noahg460505/Noahs-Independent-Study/README.md

# Noah's Independent Study
Repository for my semester long engineering self-study project.  

[Project Proposal](./Project-Proposal.md) 

[6-6-6 Plan](./6-6-6-Plan.md) 

[Daily Documentation](./Daily-Documentation.md) 

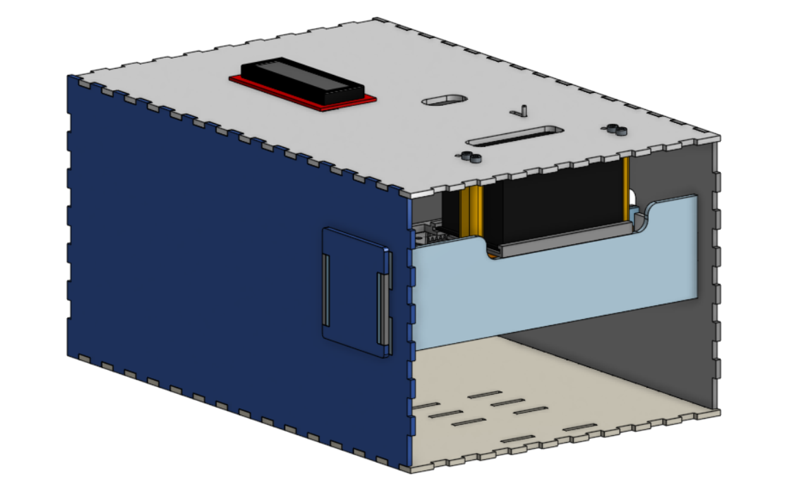
[picture p1: Media/Final CAD Screenshots/final-cad-screenshots-8.png]
Final CAD Screenshot
