noahg460505/Noahs-Independent-Study/Reflection.md

# Self-Study Project Reflection
## What did I do on the project?
    - Python code
    - Arduino code
    - Serial interface and commands
    - Prototyping
    - CAD Design
    - Glued my fingers together numerous times with CA glue

## What challenges did I overcome?
The biggest challenge that I had to overcome was the cutter for the thermal printer. It took so, so many small tweaks, and it wasn't even something I originally thought I would need to design for this project! I fully forgot that you normally have to manually tear paper off of a thermal printer, it doesn't just detach when it's done printing. Another issue I had to overcome was getting the drawer to slide smoothly, I used graphic lubricant and made a huge mess to get it to slide smoothly, but it's smooth now!

## What would I do differently?
I would absolutely decrease the scope for the project with the knowledge that a thermal printer doesn't cut it's own paper (should've been obvious, but slipped my mind). I would also consider earlier how to do the rails for the drawer and properly eject it, since I really just kinda ran out of time to design and plan that and just did random stuff (i.e. servo, gear motor spinning wheel underneath to roll drawer, etc) before running out of time with an unreliable servo design that can't retract itself, nor consistently eject itself. I would also make the rails extend longer instead of just at the front of the box so that it doesn't tilt backwards when retracted.

## What did I learn in prior classes that I applied to this project
    - CAD — every class since engineering, but Onshape from Mechatronics (widget sorter project)
    - Arduino code — From mechatronics
    - Python code — Game design 2 + Mechatronics (widget sorter project)
    - Complex Arduino wiring — Mechatronics
    - 3D printing and prototyping — Mechatronics (widget sorter project)
    - Large laser cut boxes/finger joint boxes — Mechatronics
