noahg460505/Noahs-Independent-Study/Daily-Documentation.md

# Daily Documentation
## Week 1
### Day 1 - 2026-01-29
Today I discussed my initial ideas with Mr. Small and how this independent study will actually work. I created this GitHub repository and began doing some planning, I created my initial [6-6-6 plan](./6-6-6-Plan.md).

## Week 2
### Day 2 - 2026-02-02
Today I worked on my GitHub repository more. I added an initial BOM to my [project proposal](./Project-Proposal.md) and created [Daily-Documentation.md](Daily-Documentation.md)

### Day 3 - 2026-02-04
Today I really didn't feel like working on the GitHub repo so I started on some [Python code](./Code/main.py).

### Day 4 - 2026-02-06
I think my proposal is all ready, just need to find a specific thermal printer to buy. Today I mostly just worked on my Health 2 online stuff during class.

## Week 3
### Day 5 - 2026-02-10
Today I once again just worked on Health 2 online stuff while waiting for Mr. Small, he told me he was gonna look at the project proposal this weekend but he was busy, hopefully next class?

### Day 6 - 2026-02-12
Today I worked more on the Python code because I was tired
why do i only ever feel like doing code when im tired

Next class I think I'll start prototyping, assuming Mr. Small looks at my project proposal over the weekend.

## Week 4
### Day 7 - 2026-02-17
Today I talked to Mr. Small and discussed my project and ordering a thermal printer for the project. I also worked on the Python code a bit more.

### Day 8 - 2026-02-19
Worked on Arduino code for most of the time, once I got the Arduino IDE working on my laptop.
I'm tired, my birthday was yesterday, I stayed up kinda late

## Week 5
### Day 9 - 2026-02-23
Today I did wiring for the character LCD and got the display fully working! I finished the [display Arduino code](./Code/arduinoSelfStudyCode.ino) and worked on the [Python code](./Code/main.py) a bit more.  
No Messages Waiting   
Countdown   
[Countdown Test Video](/Media/2026-02-23-Countdown-Test.mp4)   

### Day 10 - 2026-02-25
Today I tried to get some motor stuff running for testing, but I instead just shorted everything, including my laptop's USB-A port, thought I fully fried my laptop, it wouldn't turn back on, not even the keyboard backlight or display would light up. Fixed it by holding the power button for a minute, then waiting 30 minutes. Luckily, my laptop survived, it powered on after half-an-hour. Didn't get much done other than fail to get motors running and shorting stuff and nearly killing my rather expensive laptop.

### Day 11 - 2026-02-27
Today I just spent all of class diagnosing wiring issues, I was really struggling getting stuff to work. It appears that last class I fried the Arduino, it wouldn't do anything. I was trying to get motors to spin all class before I realized "Oh, I probably fried the H-Bridge too" so next class I'll replace the H-Bridge and run some tests.  
Dead Arduino  

## Week 6
### Day 12 - 2026-03-03
Yup, that H-Bridge was dead, after replacing it everything works!  
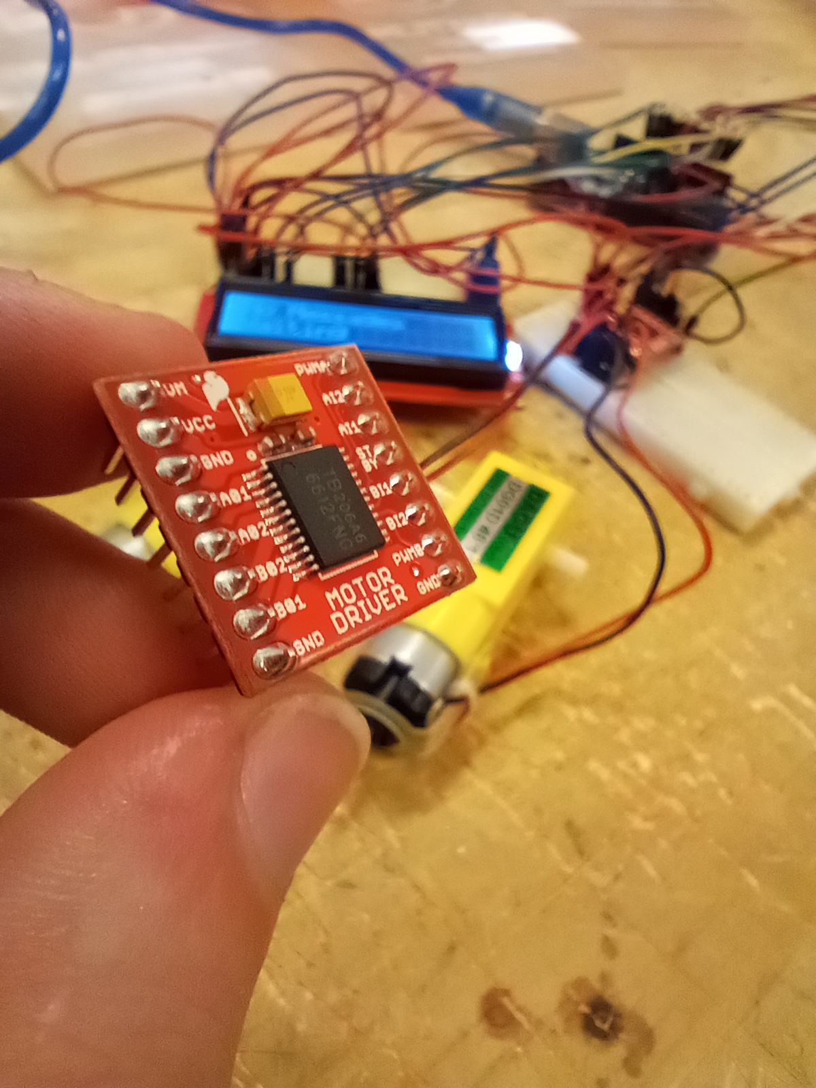
[picture p2: Media/2026-03-03-dead-h-bridge.jpg]
Dead H-Bridge
  
Supposed to have a deliverable this week, dunno how possible that's gonna be since I don't yet have the printer, although maybe the code + fully working wiring could count as a deliverable? I'll have to ask!  

Wiring on Table
   
Wiring Top View   
[Motor Test Video](/Media/2026-03-03-Motor-Test.mp4)   

### Day 13 - 2026-03-05
So today I realized two things, one is that I'll either need an Arduino Mega or a second Arduino Uno to add the thermal printer and possibly a servo if I add it. The other thing I realized is that most thermal printers don't have an autocutter, including mine, so I'll need to somehow mechanically cut the paper as it comes out of the thermal printer, it has a serrated edge that you are supposed to yank the paper against. I also permanently changed my USB permissions on my laptop for the Arduino serial so I don't need to do `sudo chmod a+rw /dev/ttyACM0` every time I plug in the Arduino.

    Current ideas:  
    - have some feeder wheels to yank it against the serrated edge  
    - have a razor blade that slides against the paper with a linear actuator with the paper under tension

## Week 7
### Day 14 - 2026-03-09
I mainly just worked on a personal project today during class because I'm still waiting on the thermal printer (Supposed to show up next week). Next class I might work on figuring out wiring up a second Arduino for running the printer.

### Day 15 - 2026-03-11
Honestly just worked on my Health 2 online stuff and also my personal project, really just waiting on the thermal printer for prototyping.
  
### Day 16 - 2026-03-13
Thermal printer has been delayed again, will be here on March 20th apparently. Since I really don't wanna do nothing for another week I think I'll try to begin on CAD.

## Week 8
### Day 17 - 2026-03-17
CAD

### Day 18 - 2026-03-19
more CAD

## Week 9
### Day 19 - 2026-03-30
Today I worked on a bit more CAD and also got an update on shipping for my thermal printer, it's arriving today! It keeps getting delayed but it should finally show up, then I can get it wired and finally begin making a housing for it.

### Day 20 - 2026-04-01
Today I FINALLY got my thermal printer, I did some test prints and got it working. I had to do a really jank solution to get it running as it needed 9v to work properly, but we only have 4 and 8 battery packs, so I had to get an 8 battery pack and then put wires to jump where two more batteries would be. I also tested how I would actually cut the paper, I found a box cutter blade segment works rather well, I think I'll have my friend Kevin design a motorized thing for moving the razor blade along the paper, as he is much better at moving, motorized systems than I am.
Thermal Printer  
Cutter Test  

### Day 21 - 2026-04-03
I was sick at home

## Week 10
### Day 22 - 2026-04-09
Tested the cutter system that Kevin helped me design, it works, somewhat, but there are some issue I need to deal with. Firstly, it is running at 9v, the motor has so much torque that the hard stop against the motor case doesn't stall the motor, it instead powers through the hard stop and breaks it off. Secondly, it has no idea if it has reached the end of the gear rack, but I might not need to fix this. I'll brainstorm how to fix this next class
Cutter Mechanism  
It broke :c  

## Week 11
### Day 23 - 2026-04-13
Today I just did some CAD, trying to figure out solutions to my problems. Namely, I designed a tip cover for the blade, hopefully this will help it cut easier and need less torque.
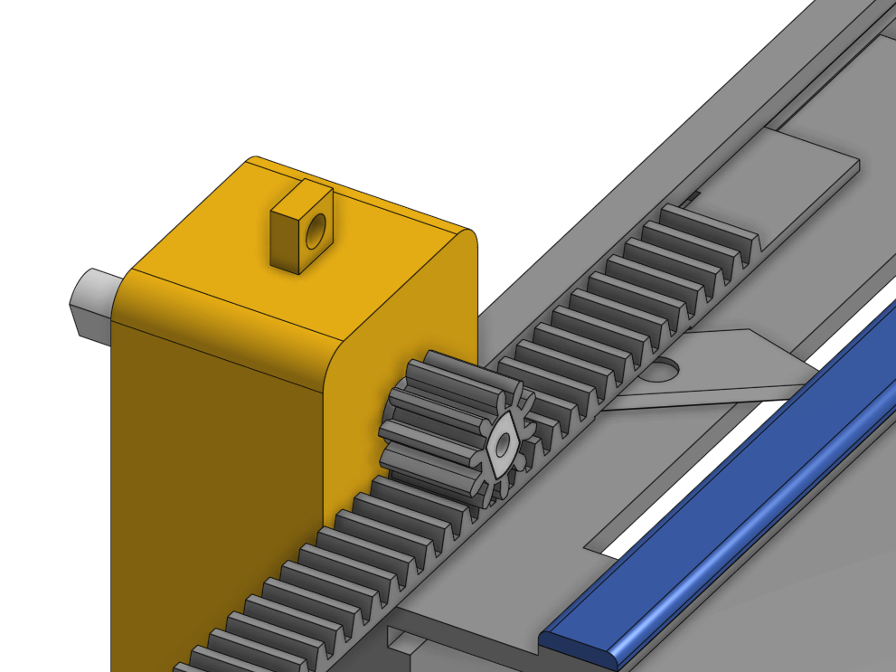
[picture p4: Media/2026-04-13-cover-on.png]
Tip Cover On
  
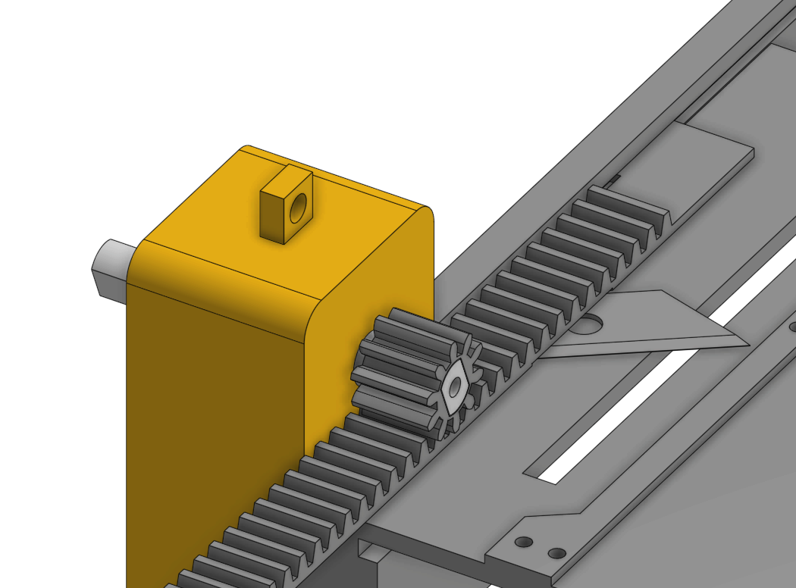
[picture p5: Media/2026-04-13-cover-off.png]
Tip Cover Off
  

### Day 24 - 2026-04-15
Today I cleaned up the CAD a bit, extended the rail the rack runs along, beefed up the hard stop, and added some mounting stuff.
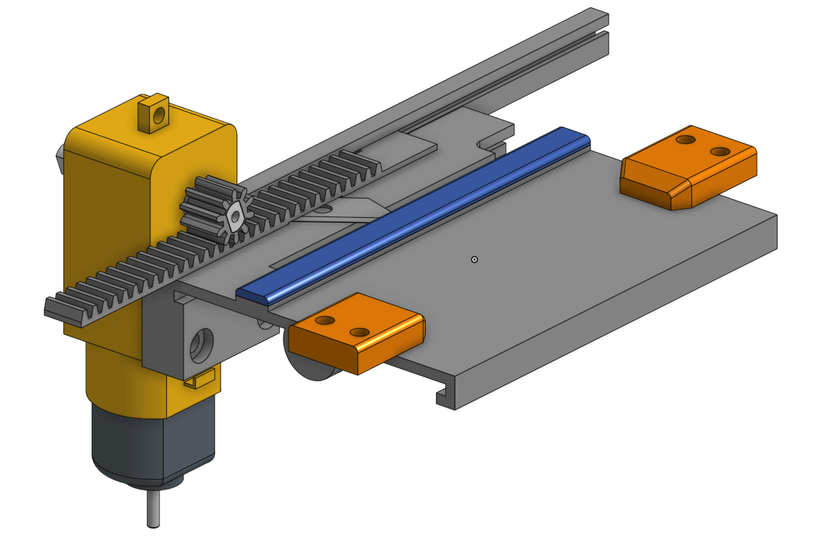
[picture p6: Media/2026-04-15-cad-update.png]
CAD Update
  
At the end of class, I was able to start printing some stuff.
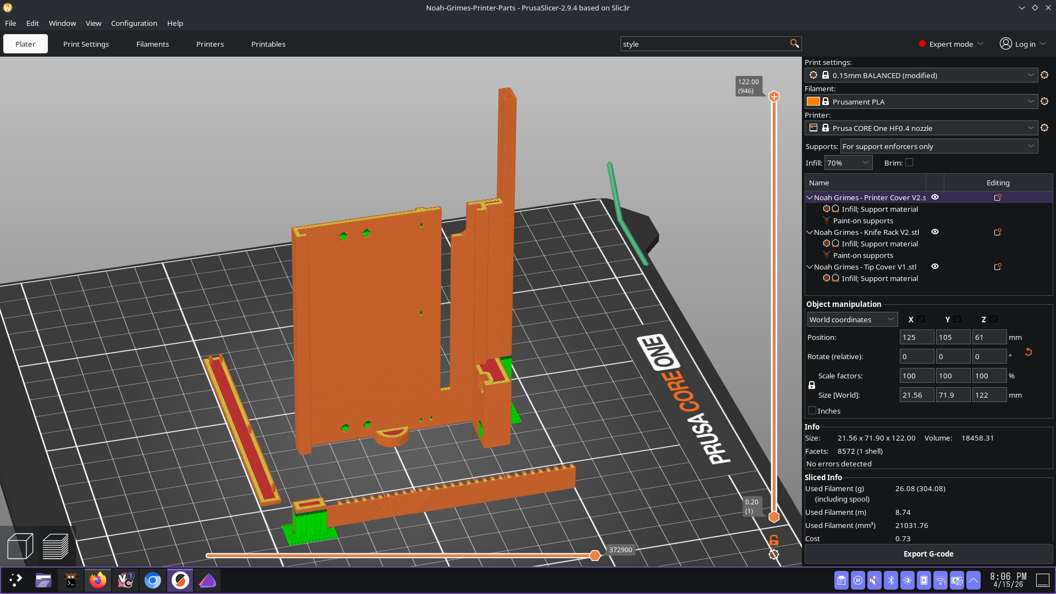
[picture p7: Media/2026-04-15-slicer-screenshot.png]
Slicer Screenshot
  

### Day 25 - 2026-04-17
Today I was visiting OSU, so I wasn't in class, but my parts I started printing are done of course.

## Week 12
### Day 26 - 2026-04-22
Today I tested some of my new printed parts, and it still isn't cutting reliably, aghhhh  
[Cutter Test](/Media/2026-04-22-Cutter-Test-Compressed.mp4)  

### Day 27 - 2026-04-24
I entirely forgot what I did

## Week 13
### Day 28 - 2026-04-28
I sharpened the knife when I was at home over the weekend, and now it cuts well, yippee!
All I gotta do now is add a stop for preventing the knife from getting stuck retracted. Will use a pen spring for that to hold it engaged.  
  
### Day 29 - 2026-04-30
I got the stopper thing working using the pen spring and a small 3D printed part I designed
[Cutter Return Test](/Media/2026-04-30-Cutter-Return-Test.mp4)  

## Week 14
### Days 29, 30, & 30
### 2026-05-04, 2026-05-06, 2026-05-08
Just been working on CAD this week, I also printed some mounting standoffs for the printer
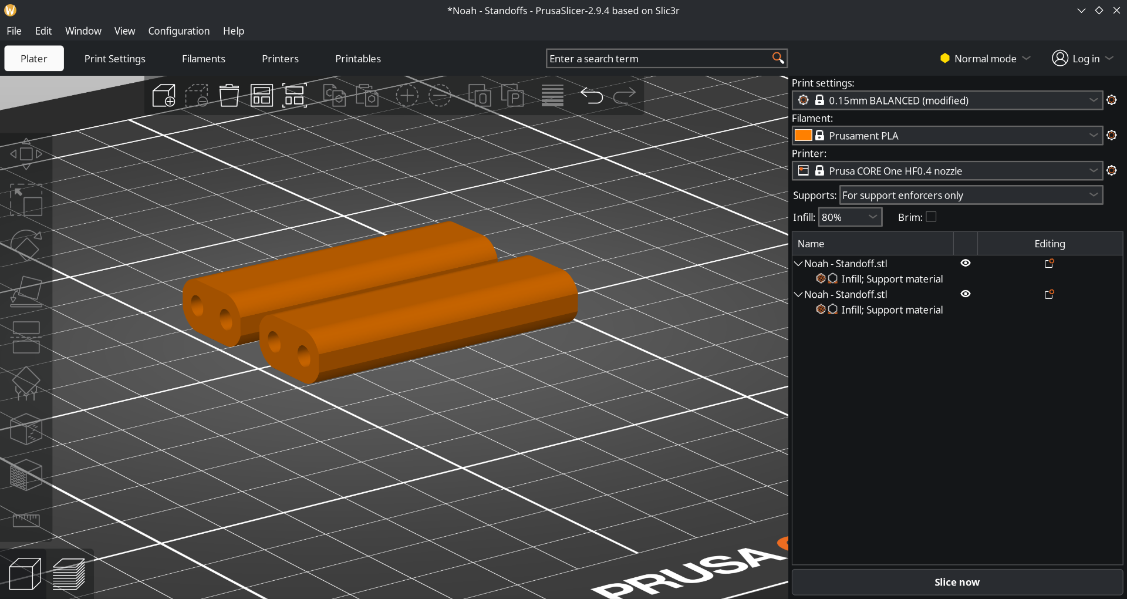
[picture p8: Media/2026-05-06-standoffs-slicer.png]
Standoffs in Prusa Slicer


## Week 15
### Day 31 - 2026-05-12
Updating documentation, then I'll further work on CAD

### Day 32 - 2026-05-14
I think CAD is complete now? I'll begin cutting next class.
Final CAD Screenshot
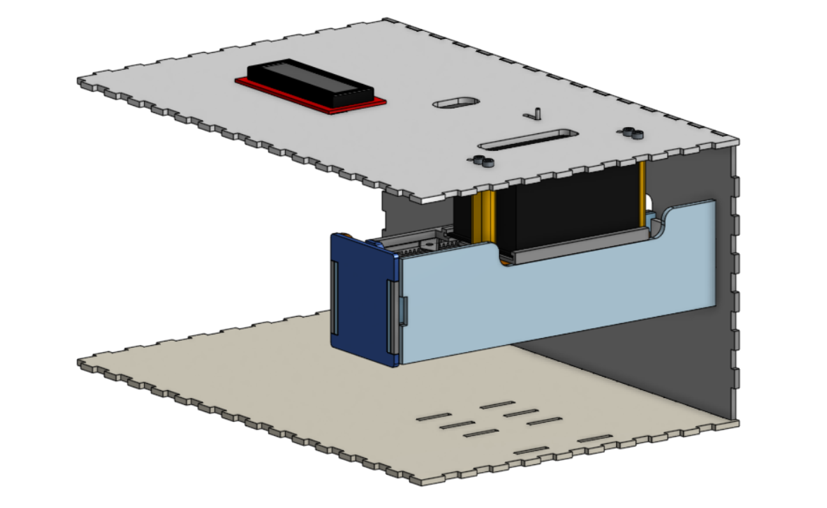
[picture p9: Media/Final CAD Screenshots/final-cad-screenshots-7.png]
Final CAD Screenshot

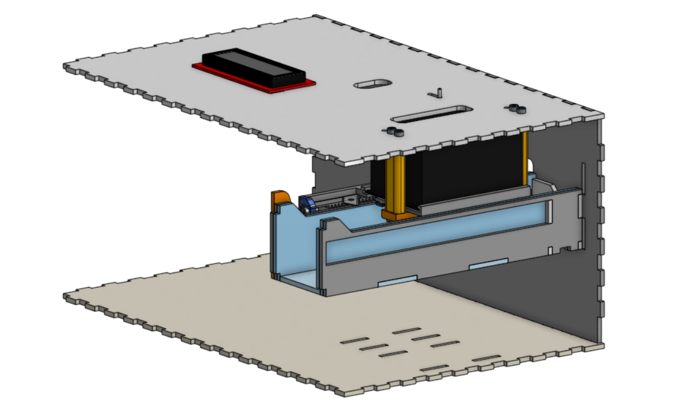
[picture p10: Media/Final CAD Screenshots/final-cad-screenshots-6.png]
Final CAD Screenshot

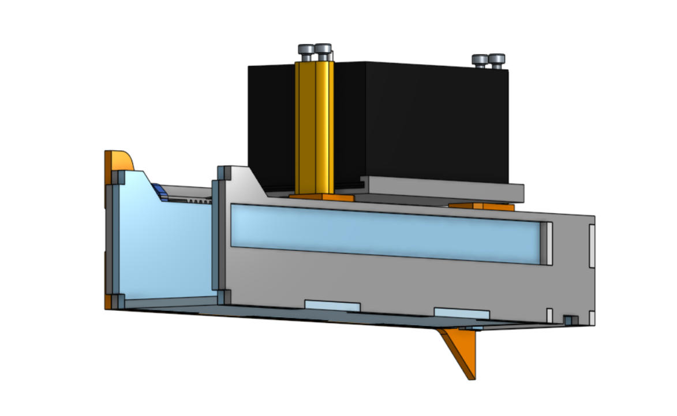
[picture p11: Media/Final CAD Screenshots/final-cad-screenshots-5.png]
Final CAD Screenshot

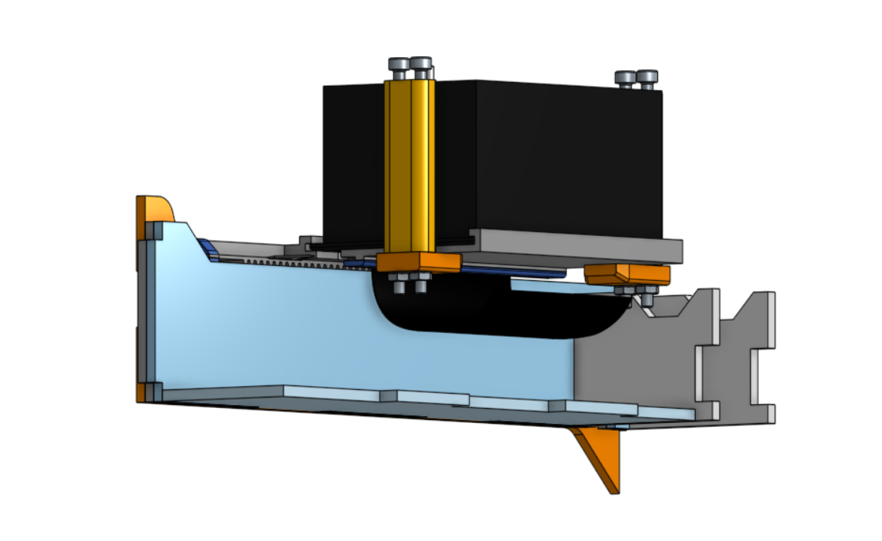
[picture p12: Media/Final CAD Screenshots/final-cad-screenshots-4.png]
Final CAD Screenshot

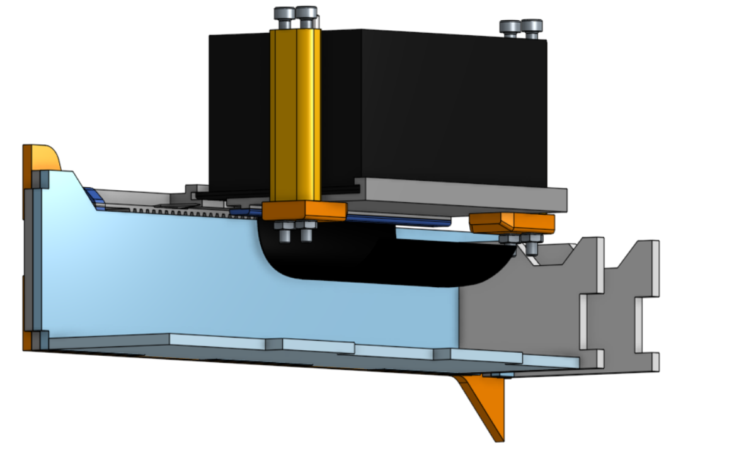
[picture p13: Media/Final CAD Screenshots/final-cad-screenshots-3.png]
Final CAD Screenshot

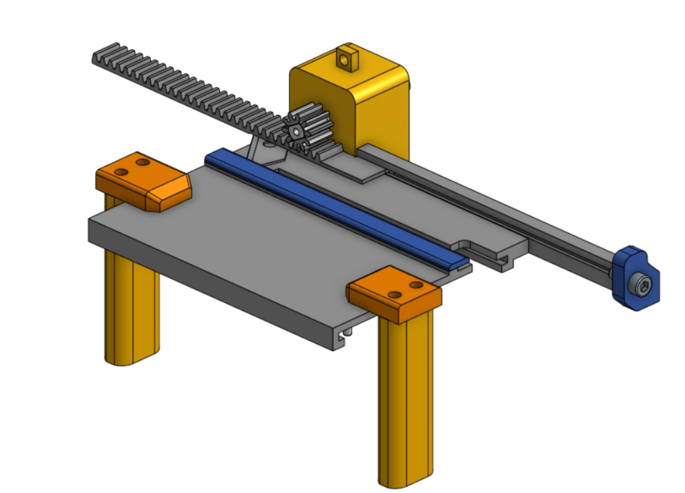
[picture p14: Media/Final CAD Screenshots/final-cad-screenshots-2.png]
Final CAD Screenshot

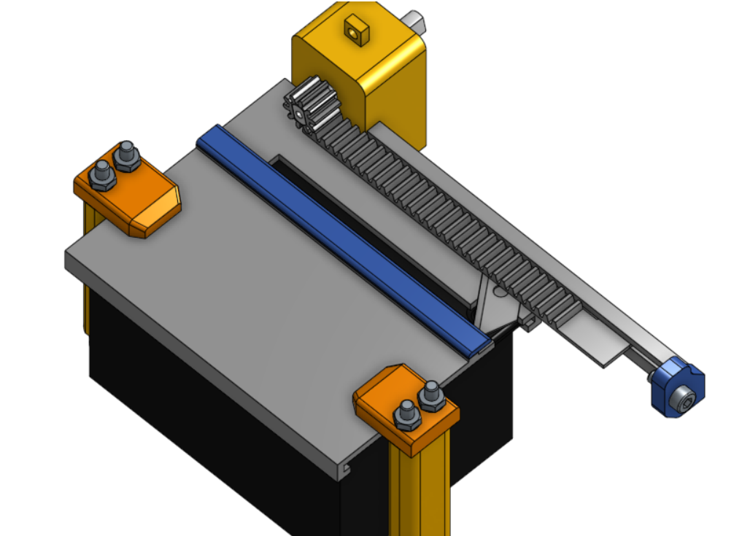
[picture p15: Media/Final CAD Screenshots/final-cad-screenshots-1.png]
Final CAD Screenshot


## Week 16
### Day 33 - 2026-05-18
I cut a bunch of stuff today, but the laser cutter was NOT happy with me today, hopefully can get the last of it cut next class.

### Day 34 - 2026-05-20
Finished cutting EVERYTHING, took the whole class because the laser cutter was angry again, but I have all the parts!

### Day 35 - 2026-05-22
Started assembling some stuff today, will finish getting everything together next class.

## Week 17
### Day 36 - 2026-05-27
EVERYTHING IS ASSEMBLED, YIPPEE!!!!!!

### Day 37 - 2026-05-29
Today I added graphite dry lubricant to make the drawer slide smoother. I made a huge mess, but it works better now.

## Week 18
### Day 38 - 2026-06-02
Today I experimented with servo ejection and updated Arduino code.

### Day 39 - 2026-06-04
Documentation!!!!! Updating this Daily-Documentation.md, adding updated code, etc. Gonna start reflection too!

## Week 19
### Day 40 - 2026-06-08
The end, I'm finishing up my documentation now.
