noahg460505/Noahs-Independent-Study/6-6-6-Plan.md

# 6-6-6 Plan
Have a demonstratable project every six weeks. I need to have a plan for extending my project if I finish early.

## First Six Weeks:
### Week 1
- Create this GitHub repository and draft a 6-6-6 plan. ✅

### Week 2
- Mr. Small is out this week, spend this week making a full project proposal, including a Bill of Materials. ✅

### Week 3
- Show Mr. Small my project proposal and discuss the proposal with him. ❌ He was pretty busy with his Robotics 1 class this week and didn't have time to review it over the weekend
- If my proposal is ready, begin prototyping and/or do preliminary CAD. 🟠 I worked on preliminary code, which is sorta the same concept

### Week 4
- Further prototyping and CAD work. Hopefully I'll have a screen and printer by this point for prototyping. ❌ Don't have printer yet, I'm just using a character LCD though so idk what I was thinking when I wrote this initially

### Week 5
- More prototyping and more CAD 🟠 More code and wiring, no CAD

### Week 6
- Have a working proof-of-concept prototype for demonstration, can be a bit clunky and ugly. 🟠 Minus thermal printer, code and wiring all work!
- Draft plan for the next six weeks of my 6-6-6 plan. 🟠 Waiting for thermal printer before doing that
- Write a reflection on how the project is going so far and where I plan to take it. ✅

## First Six Weeks Reflection
So I didn't really do much of this, still don't have a printer. BUT, I did basically do all the wiring and code for the project! During the next six weeks I want to integrate the thermal printer (as soon as I receive it) and also begin work on CAD and assembly of a housing for this whole system, probably with only one slot, although I might try to do two slots for the initial prototype.

I'll write out my 6-6-6 plan as soon as I get the thermal printer, because I really need it to know how to set my goals for the following weeks, if I get it at the start of next week that'd be optimal.

## Second Six Weeks:
### Week 7

### Week 8

### Week 9

### Week 10

### Week 11

### Week 12
- Polished, functional prototype, made from CAD designs.

## Third Six Weeks:
### Week 13

### Week 14

### Week 15

### Week 16

### Week 17

### Week 18
- Fully finished project, fully polished, functional, and professional.
