noahg460505/Noahs-Independent-Study/(commit log)

2026-02-02 Expand project proposal with materials list
    Added details about materials already available and items needed for the project.
2026-02-14 Refactor serial setup and enhance message input
    Refactor serial connection setup and improve message handling with countdown timers.
2026-02-19 Revise Day 8 documentation for clarity
    Updated Day 8 entry to reflect productive work on Arduino code after setting up the IDE.
2026-02-23 Add Arduino Code
2026-02-25 Update Daily Documentation with Day 10 entry
    Added Day 10 entry detailing motor testing and laptop incident.
2026-03-03 Add motor test video
2026-03-03 Add wiring photos for today
2026-03-05 Document Day 13 insights on thermal printer setup
    Added notes about thermal printer requirements and ideas for cutting mechanism.
2026-03-05 Revise week 6 plan due to thermal printer delay
    Updated the draft plan for the next six weeks to reflect waiting on the thermal printer before proceeding.
2026-03-05 Implement motor control for message ejection
    Added motor control functionality to eject messages based on input commands.
2026-03-05 Modify message storage limit and enhance sudo commands
    Updated the maximum number of messages that can be stored and changed the serial port. Added new sudo commands and improved error handling.
    [main.py]
2026-03-05 Update Day 13 notes with new Arduino insights
    Added details about USB permissions for Arduino and mechanical cutting ideas for thermal printer.
2026-03-13 Add entry for Day 16 and update thermal printer status
2026-03-19 Add entries for Week 8 and CAD progress
2026-04-01 Add updates for thermal printer setup and testing
    Documented the arrival and setup of the thermal printer, including test prints and cutting mechanism.
2026-04-15 Update Daily Documentation with recent progress
    Added entries for Days 22 to 24, detailing testing and CAD work on the cutter system.
2026-04-16 Update Day 24 with printing notes and screenshot
    Added notes about starting prints and included a screenshot.
2026-04-24 Document updates for weeks 10 to 12
    Added updates for weeks 10, 11, and 12, including CAD designs and testing results.
2026-05-12 Update Daily Documentation for Weeks 13 to 15
    Added updates for Days 29 to 31, including progress on the knife stopper and CAD work.
2026-06-04 Add servo control logic and cutter controls to Arduino code
2026-06-04 fix typo and clarity issue
    [arduinoSelfStudyCode.ino]
2026-06-08 add file CAD screenshots
2026-06-08 Include final CAD screenshot in README
    Add final CAD screenshot to README
2026-06-08 Update Daily-Documentation with CAD screenshots
    Added final CAD screenshots to documentation.
