noahg460505/Noahs-Independent-Study/Media/2026-03-03-wiring-on-table.jpg

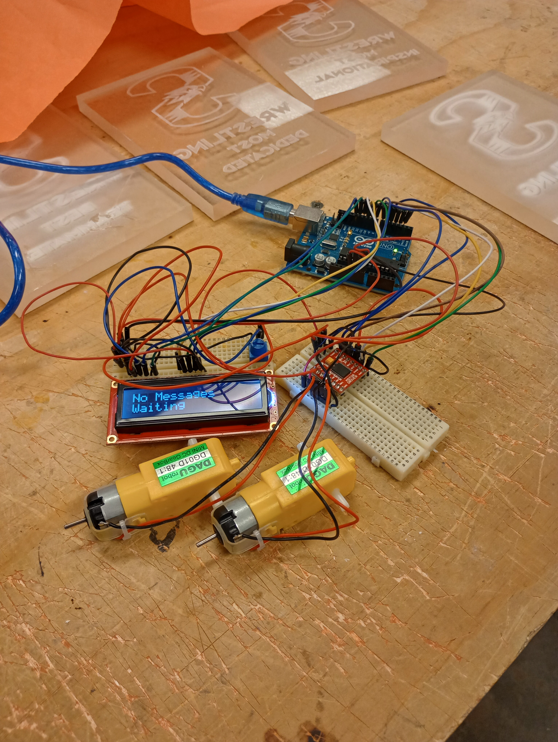
[picture p3: Media/2026-03-03-wiring-on-table.jpg]
Media/2026-03-03-wiring-on-table.jpg
